kinoshita-lab/kinoshi-tiny-key-25/hardware/acrylic/kinoshi-tiny-key_acrylic-Edge_Cuts.dxf

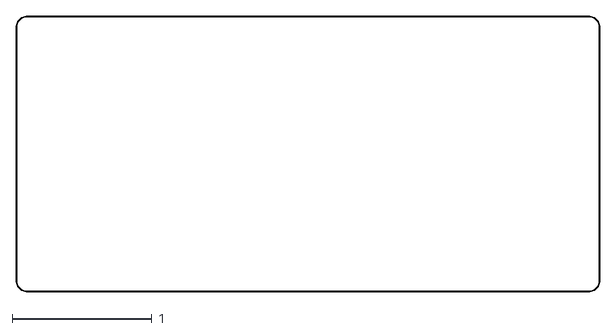
[picture p3: CAD file, 2025-10-02]
hardware/acrylic/kinoshi-tiny-key_acrylic-Edge_Cuts.dxf
4.18 x 1.97
