kinoshita-lab/kinoshi-tiny-key-25/hardware/kinoshi-tiny-key-25-pcb.pdf

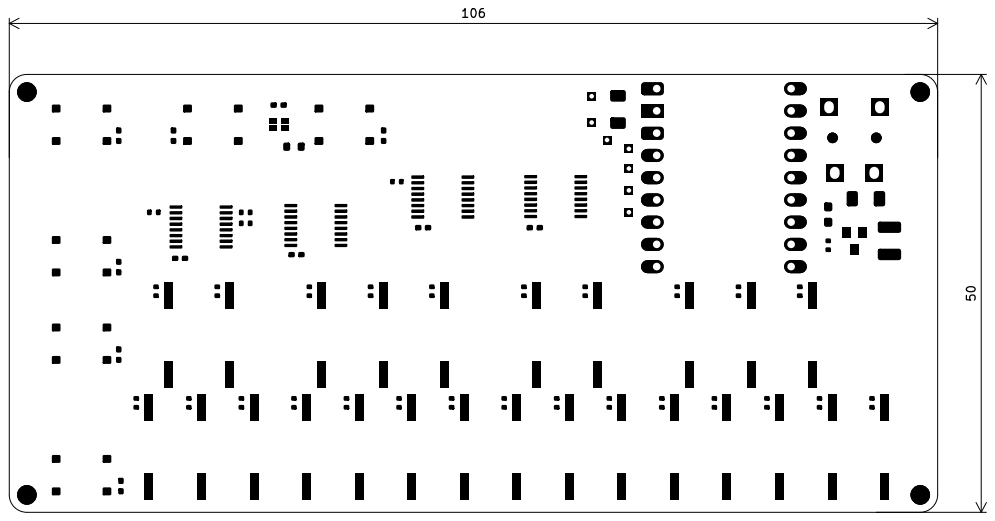
[picture p4: page 1]
