kinoshita-lab/kinoshi-tiny-key-25/hardware/kinoshi-tiny-key-25-schematics.pdf

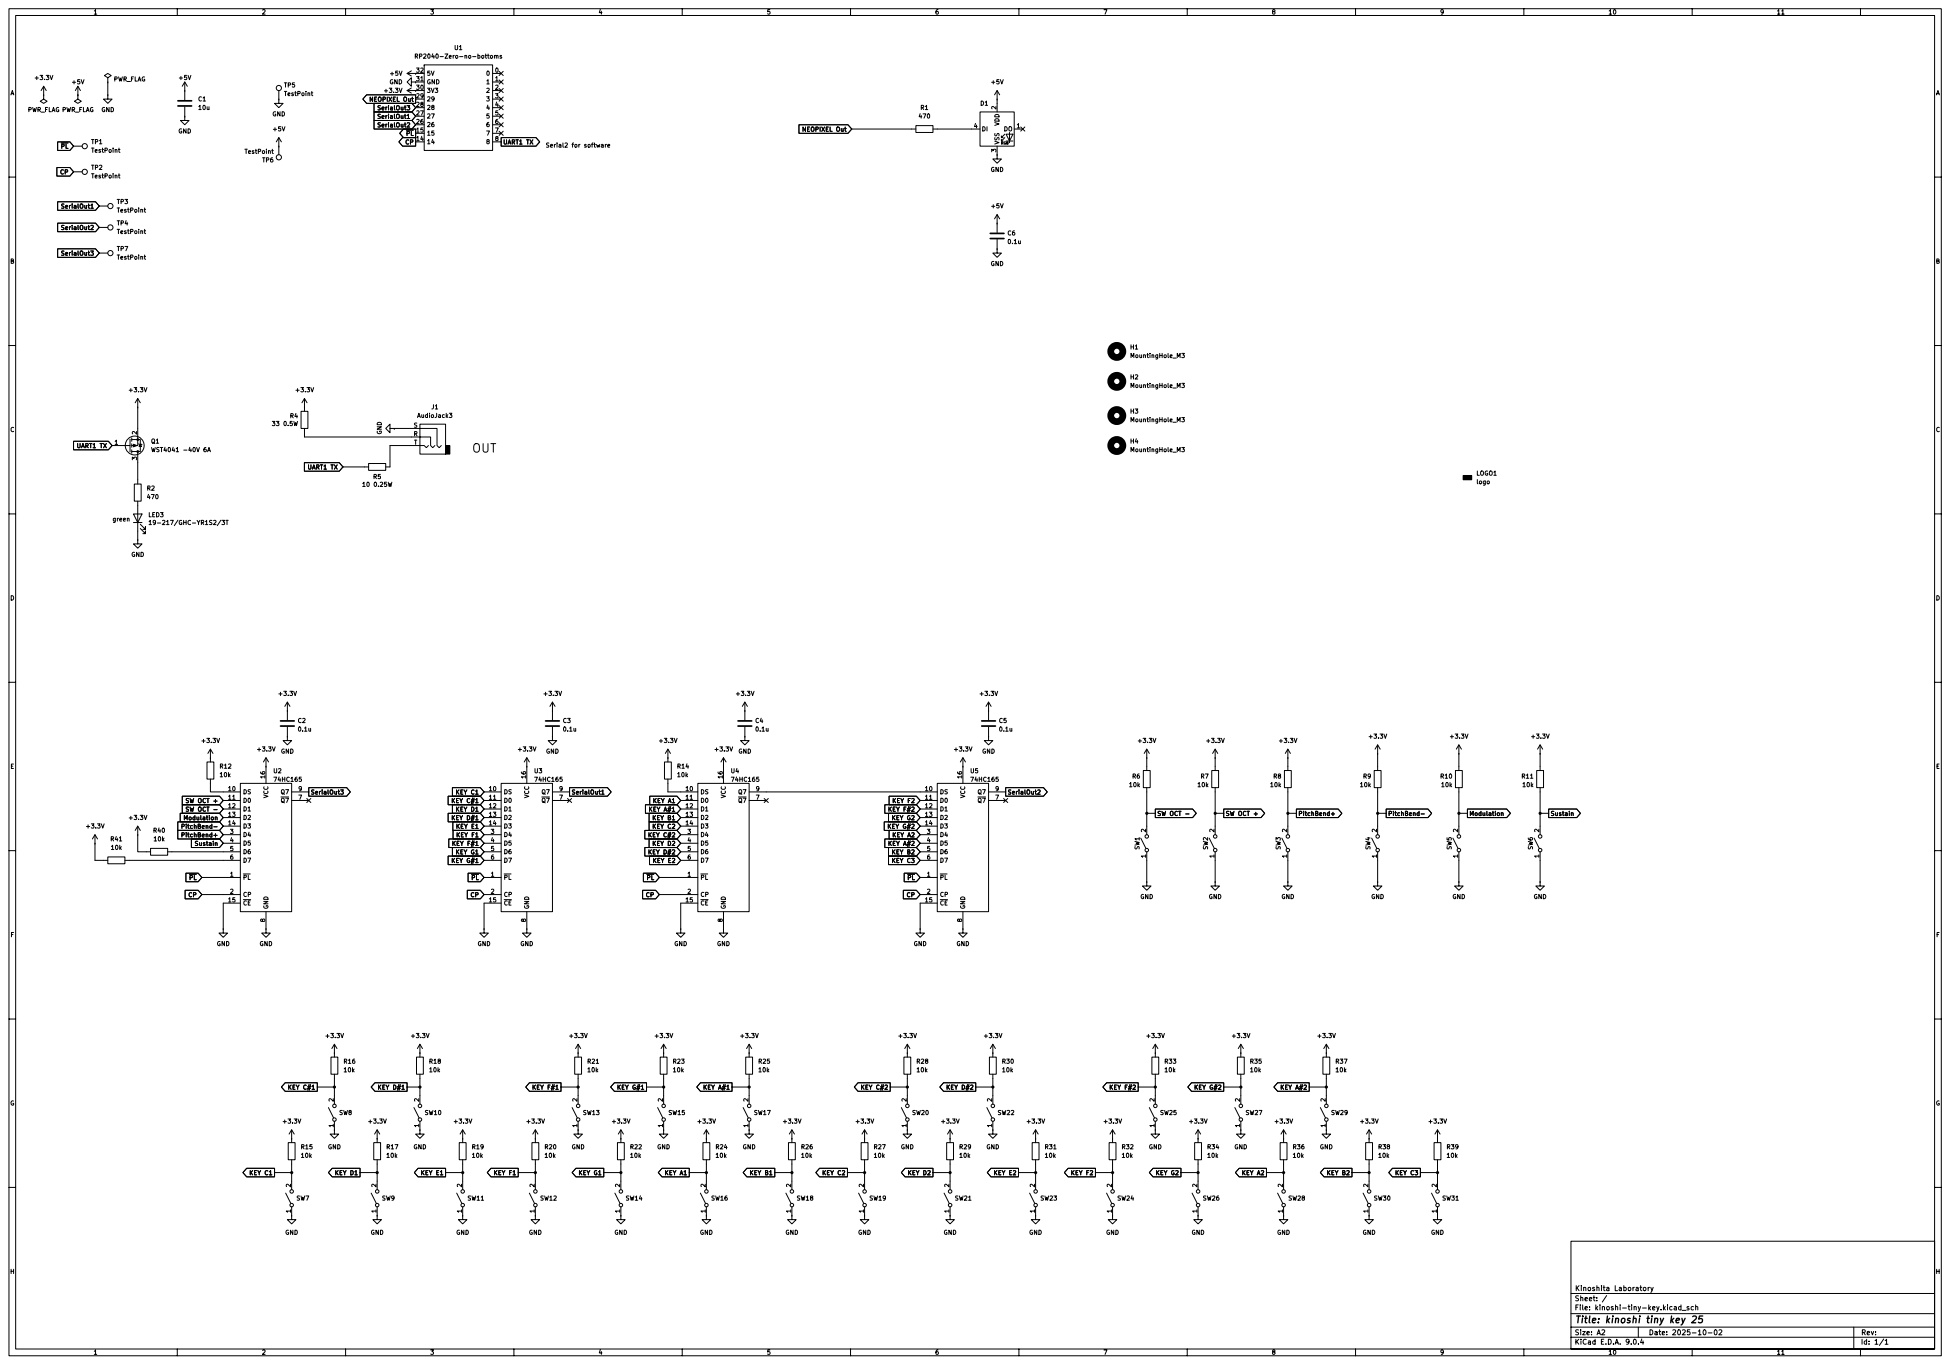
[picture p5: page 1]
