kinoshita-lab/kinoshi-tiny-key-25/hardware/kinoshi-tiny-key.kicad_pcb

## KiCad design hardware/kinoshi-tiny-key.kicad_pcb (2026-08-29)

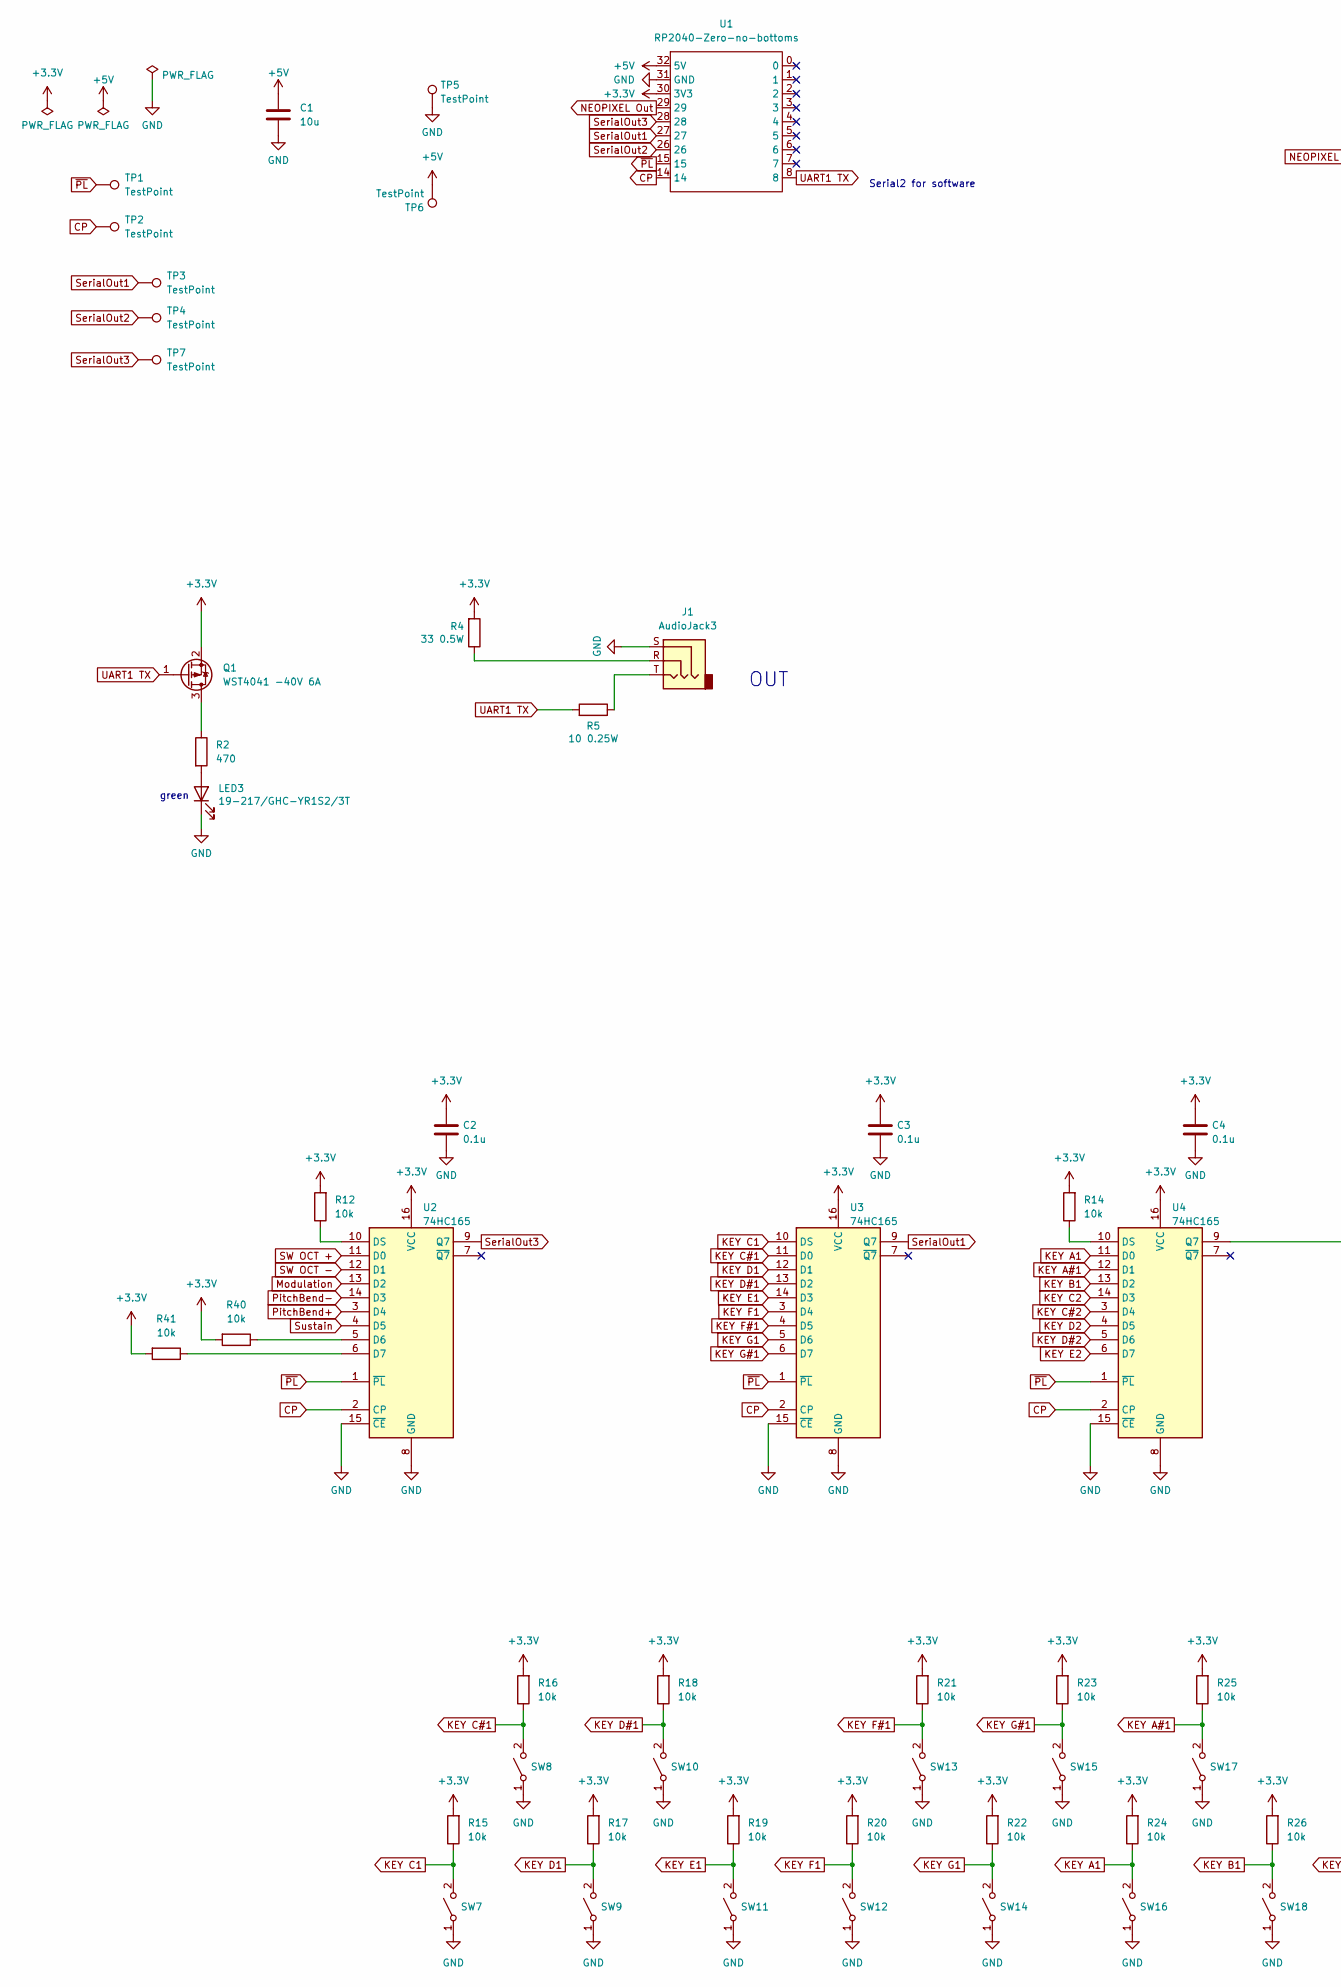
[picture p6: schematic kinoshi-tiny-key.kicad_sch, kinoshi tiny key 25, part in row 1, column 1]

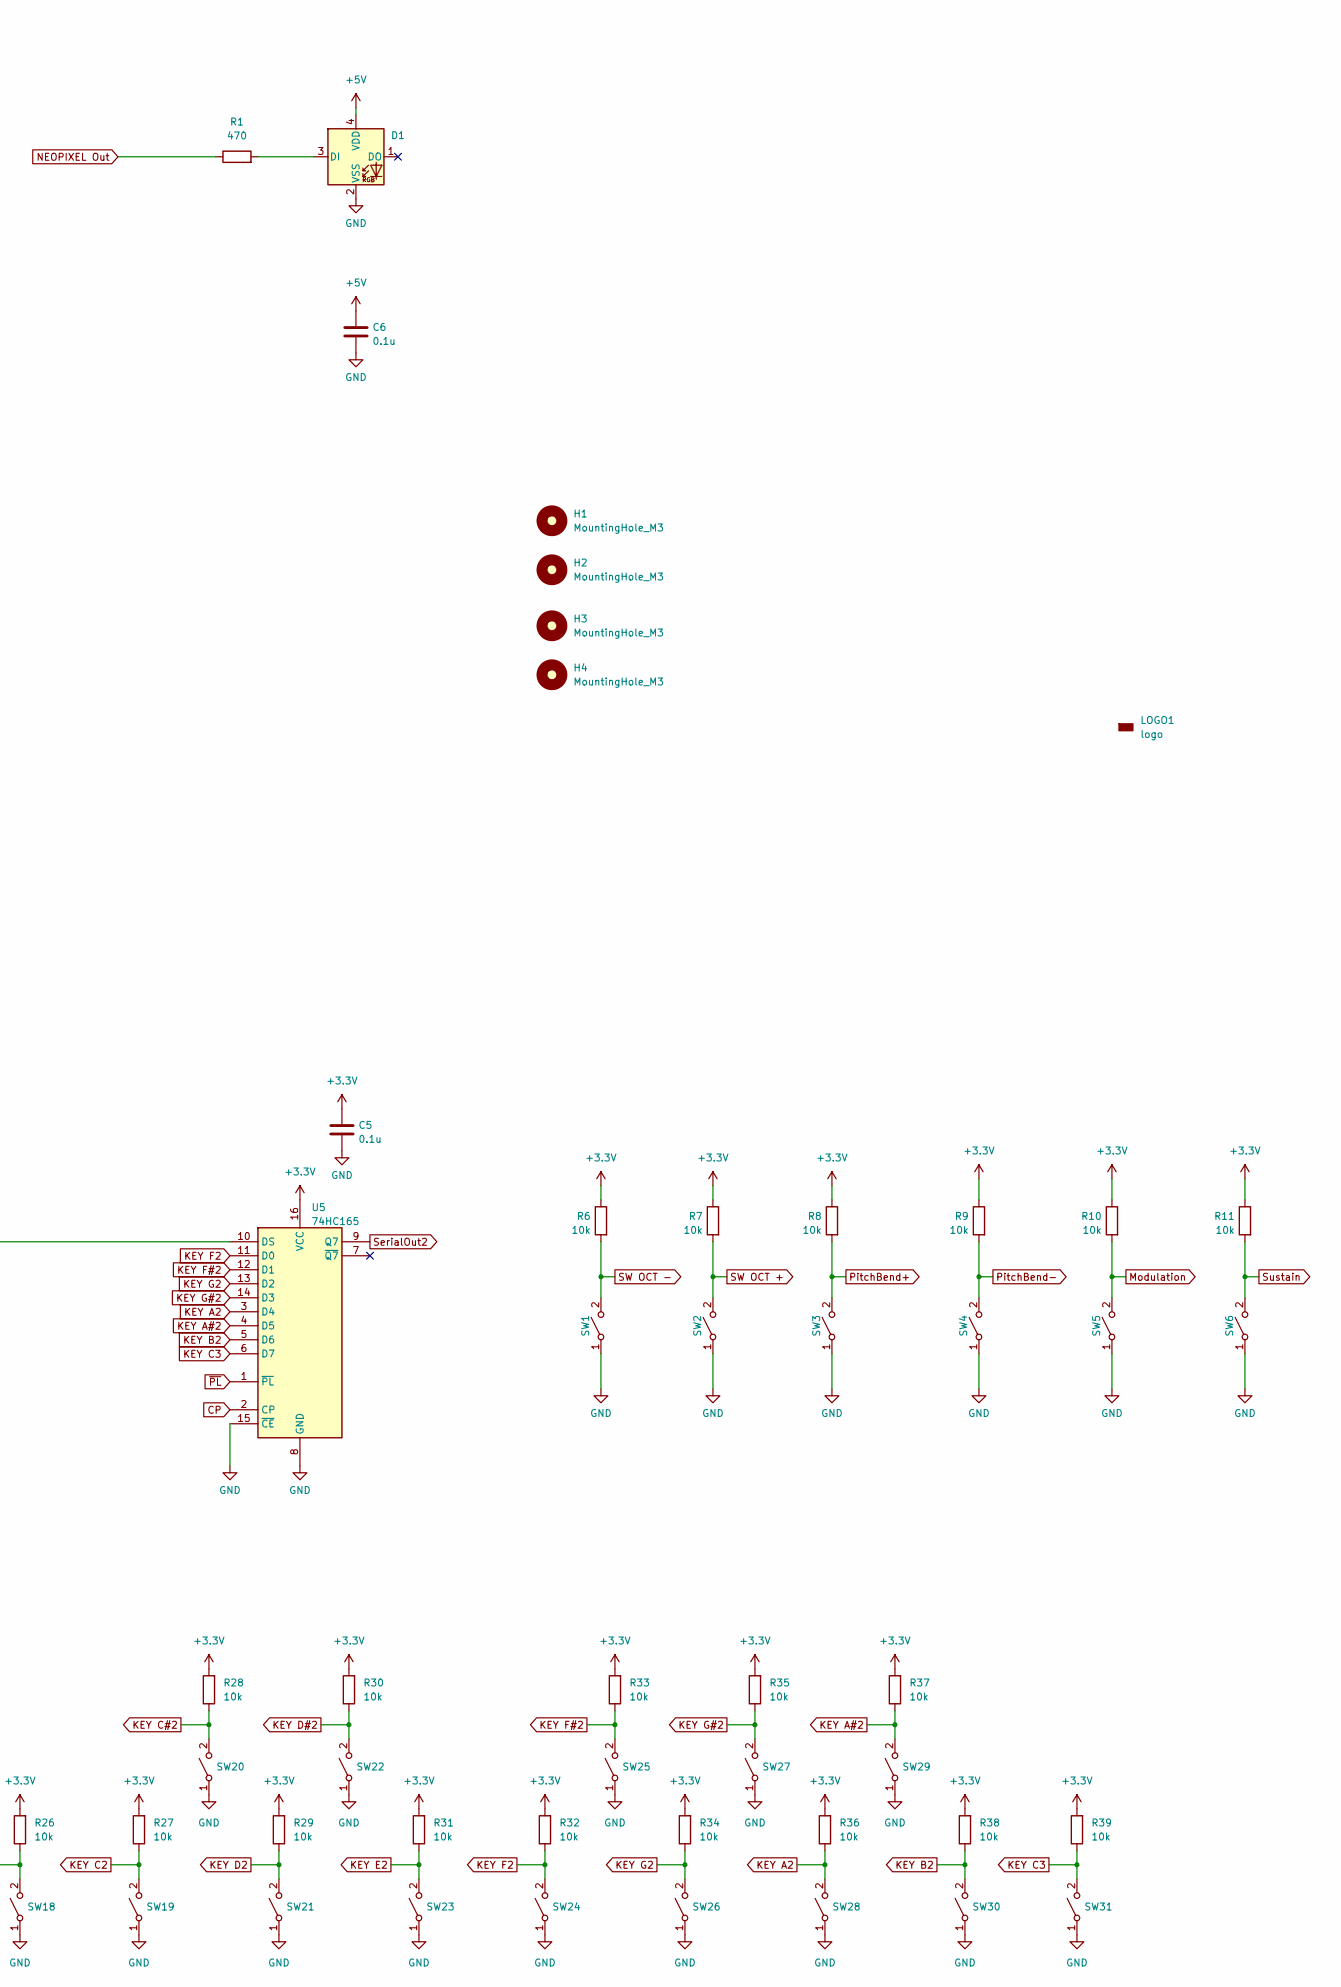
[picture p7: schematic kinoshi-tiny-key.kicad_sch, kinoshi tiny key 25, part in row 1, column 2]

Parts:
C1: 10u; C_1206_3216Metric_Pad1.33x1.80mm_HandSolder; LCSC C13585
C2, C3, C4, C5, C6: 0.1u; C_0402_1005Metric_Pad0.74x0.62mm_HandSolder; LCSC C1525
D1: LED_NeoPixel_CHONGTIAN_CT-1615UGRBC/H-P6-5_C52191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; LED_NeoPixel_CHONGTIAN CT-1615UGRBCH-P6-5_C52191312; LCSC C52191312
H1, H2, H3, H4: MountingHole_M3; MountingHole_2.2mm_M2
J1: AudioJack3; 3.5mm_Stereo_TRS_PJ-3210-4A_and_ST-005-G; LCSC C136686
LED3: 19-217/GHC-YR1S2/3T; LED_0603_1608Metric_Pad1.05x0.95mm_HandSolder; LCSC C72043
LOGO1: logo; kinoshita-logo_simplified_300dpi
Q1: WST4041 -40V 6A; SOT-23; LCSC C148357
R1: 470; R_0603_1608Metric; LCSC C23179
R2: 470; R_0402_1005Metric; LCSC C25117
R4: 33 0.5W; R_1210_3225Metric_Pad1.30x2.65mm_HandSolder; LCSC C407192
R5: 10 0.25W; R_1206_3216Metric_Pad1.30x1.75mm_HandSolder; LCSC C17903
R6, R7, R8, R9, R10, R11: 10k; R_0402_1005Metric_Pad0.72x0.64mm_HandSolder; LCSC C25744
R12, R14, R15, R16, R17, R18, R19, R20, R21, R22, R23, R24, R25, R26, R27, R28, R29, R30, R31, R32, R33, R34, R35, R36, R37, R38, R39, R40, R41: 10k; R_0402_1005Metric; LCSC C25744
SW1, SW2, SW3, SW4, SW5, SW6: SW_SPST; Switch_Tactile_TS1187A26017_C22459525; LCSC C22459525
SW7, SW8, SW9, SW10, SW11, SW12, SW13, SW14, SW15, SW16, SW17, SW18, SW19, SW20, SW21, SW22, SW23, SW24, SW25, SW26, SW27, SW28, SW29, SW30, SW31: SW_SPST; Switch_Tactile_TSB008A2518A_C2888455; LCSC C2888456
TP1, TP2, TP3, TP4, TP5, TP6, TP7: TestPoint; TestPoint_THTPad_1.0x1.0mm_Drill0.5mm
U1: RP2040-Zero-no-bottoms; RP2040-Zero-THT-no-bottoms
U2, U3, U4, U5: 74HC165; TSSOP-16_4.4x5mm_P0.65mm; LCSC C80696

Connections:
+3.3V: C2.1, C3.1, C4.1, C5.1, Q1.2 (S), R4.2, R6.1, R7.1, R8.1, R9.1, R10.1, R11.1, R12.2, R14.2, R15.2, R16.2, R17.2, R18.2, R19.2, R20.2, R21.2, R22.2, R23.2, R24.2, R25.2, R26.2, R27.2, R28.2, R29.2, R30.2, R31.2, R32.2, R33.2, R34.2, R35.2, R36.2, R37.2, R38.2, R39.2, R40.2, R41.2, U1.30 (3V3), U2.16 (VCC), U3.16 (VCC), U4.16 (VCC), U5.16 (VCC)
+5V: C1.1, C6.1, D1.4 (VDD), TP6.1 (1_1), U1.32 (5V)
CP: TP2.1 (1_1), U1.14, U2.2 (CP), U3.2 (CP), U4.2 (CP), U5.2 (CP)
GND: C1.2, C2.2, C3.2, C4.2, C5.2, C6.2, D1.2 (VSS), J1.S, LED3.1 (K), SW1.1 (A), SW2.1 (A), SW3.1 (A), SW4.1 (A), SW5.1 (A), SW6.1 (A), SW7.1 (A), SW8.1 (A), SW9.1 (A), SW10.1 (A), SW11.1 (A), SW12.1 (A), SW13.1 (A), SW14.1 (A), SW15.1 (A), SW16.1 (A), SW17.1 (A), SW18.1 (A), SW19.1 (A), SW20.1 (A), SW21.1 (A), SW22.1 (A), SW23.1 (A), SW24.1 (A), SW25.1 (A), SW26.1 (A), SW27.1 (A), SW28.1 (A), SW29.1 (A), SW30.1 (A), SW31.1 (A), TP5.1 (1_1), U1.31 (GND), U2.8 (GND), U2.15 (~CE), U3.8 (GND), U3.15 (~CE), U4.8 (GND), U4.15 (~CE), U5.8 (GND), U5.15 (~CE)
KEY A1: R24.1, SW16.2 (B), U4.11 (D0)
KEY A2: R36.1, SW28.2 (B), U5.3 (D4)
KEY A#1: R25.1, SW17.2 (B), U4.12 (D1)
KEY A#2: R37.1, SW29.2 (B), U5.4 (D5)
KEY B1: R26.1, SW18.2 (B), U4.13 (D2)
KEY B2: R38.1, SW30.2 (B), U5.5 (D6)
KEY C1: R15.1, SW7.2 (B), U3.10 (DS)
KEY C2: R27.1, SW19.2 (B), U4.14 (D3)
KEY C3: R39.1, SW31.2 (B), U5.6 (D7)
KEY C#1: R16.1, SW8.2 (B), U3.11 (D0)
KEY C#2: R28.1, SW20.2 (B), U4.3 (D4)
KEY D1: R17.1, SW9.2 (B), U3.12 (D1)
KEY D2: R29.1, SW21.2 (B), U4.4 (D5)
KEY D#1: R18.1, SW10.2 (B), U3.13 (D2)
KEY D#2: R30.1, SW22.2 (B), U4.5 (D6)
KEY E1: R19.1, SW11.2 (B), U3.14 (D3)
KEY E2: R31.1, SW23.2 (B), U4.6 (D7)
KEY F1: R20.1, SW12.2 (B), U3.3 (D4)
KEY F2: R32.1, SW24.2 (B), U5.11 (D0)
KEY F#1: R21.1, SW13.2 (B), U3.4 (D5)
KEY F#2: R33.1, SW25.2 (B), U5.12 (D1)
KEY G1: R22.1, SW14.2 (B), U3.5 (D6)
KEY G2: R34.1, SW26.2 (B), U5.13 (D2)
KEY G#1: R23.1, SW15.2 (B), U3.6 (D7)
KEY G#2: R35.1, SW27.2 (B), U5.14 (D3)
Modulation: R10.2, SW5.2 (B), U2.13 (D2)
NEOPIXEL Out: R1.1, U1.29
unnamed: D1.3 (DI), R1.2
unnamed: J1.R, R4.1
unnamed: J1.T, R5.1
unnamed: LED3.2 (A), R2.2
unnamed: Q1.3 (D), R2.1
unnamed: R40.1, U2.5 (D6)
unnamed: R41.1, U2.6 (D7)
unnamed: R12.1, U2.10 (DS)
unnamed: R14.1, U4.10 (DS)
unnamed: U4.9 (Q7), U5.10 (DS)
PitchBend+: R8.2, SW3.2 (B), U2.3 (D4)
PitchBend-: R9.2, SW4.2 (B), U2.14 (D3)
SW OCT +: R7.2, SW2.2 (B), U2.11 (D0)
SW OCT -: R6.2, SW1.2 (B), U2.12 (D1)
SerialOut1: TP3.1 (1_1), U1.27, U3.9 (Q7)
SerialOut2: TP4.1 (1_1), U1.26, U5.9 (Q7)
SerialOut3: TP7.1 (1_1), U1.28, U2.9 (Q7)
Sustain: R11.2, SW6.2 (B), U2.4 (D5)
UART1 TX: Q1.1 (G), R5.2, U1.8
~PL: TP1.1 (1_1), U1.15, U2.1 (~PL), U3.1 (~PL), U4.1 (~PL), U5.1 (~PL)

Notes on the sheet:
OUT
Serial2 for software
green

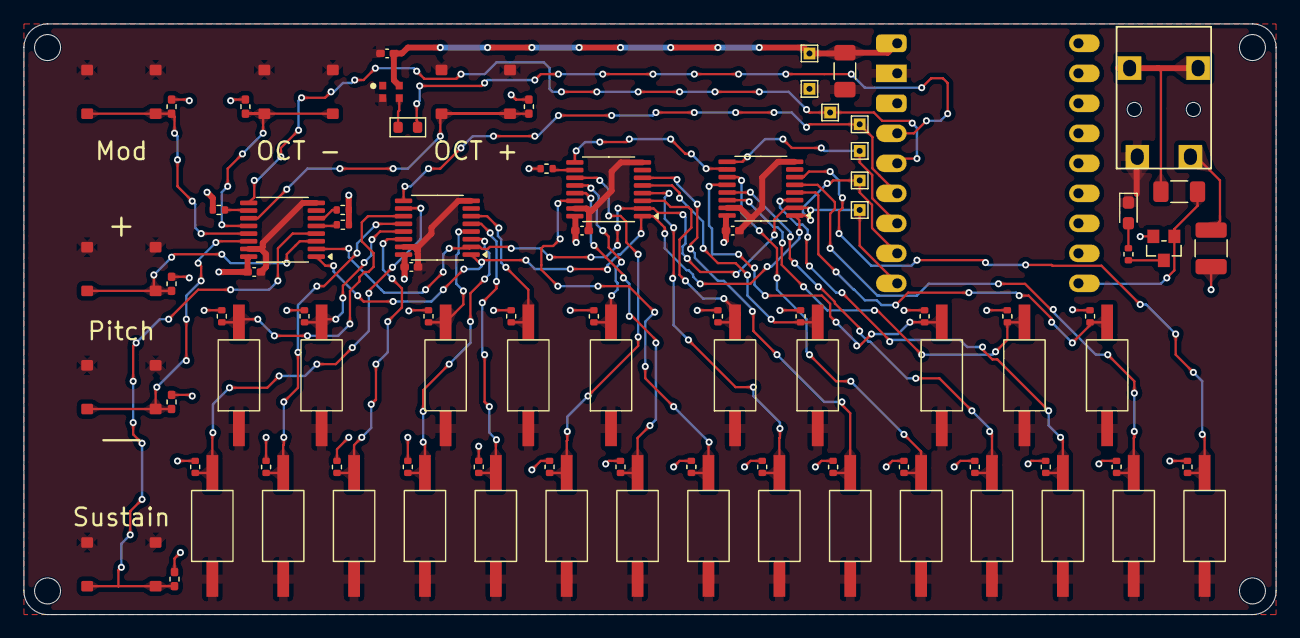
[picture p8: board kinoshi-tiny-key.kicad_pcb from above]

Board: 2 copper layers, 106.0 x 50.0 mm, 97 parts (1 on the bottom side), 51 nets.
