kinoshita-lab/kinoshi-tiny-key-25/software/kinoshi-tiny-key-25/src/application.cpp

/**
 * @file	application.cpp
 * @brief	Application logic for Tiny KinoKey 25
 * @author Kazuki Saita <saita@kinoshita-lab.com>
 * Copyright (c) 2025 Kinoshita Laboratory All rights reserved.
 */
#include <Arduino.h>
#include <algorithm>
#include "application.h"
#include "leds.h"
#include "device_config.h"
#include "switch.hpp"
#include "midi_process.h"
#include "pins.h"
#include "user_config.h"
#include "setting_transfer.h"

extern "C" {
#include "pico/bootrom.h"
}

namespace kinoshita_lab::kinoshi_tiny_key_25::application
{
namespace
{
enum ButtonIndex
{
    kButtonMod,
    kButtonPitchUp,
    kButtonPitchDown,
    kButtonSustain,
    kNumButtons,
};

switches::Switches switches_(pins::kPinPl, pins::kPinCp, pins::kPinSerialOut1, pins::kPinSerialOut2, pins::kPinSerialOut3, nullptr);

struct Status
{
    bool timer_fired            = false;
    int current_octave          = device_config::kDefaultOctave;
    int16_t pitch_bend_value    = 0;  // center
    int pitch_bend_direction    = 0;  // -1, 0, 1
    bool should_send_pitch_bend = false;
    const float pitch_bend_step = (8192.f / (device_config::pitch_bend_time / 1000.f)) / (1000.f * 1000.f / device_config::kApplicationTimerIntervalUs);  // per timer tick
    struct KeyboardStatus
    {
        bool shouldSend;
        bool offOn;
        int8_t noteOnNoteNumber = -1;  // MIDI note number for "Note On" event
    };
    KeyboardStatus keyboard_status[device_config::kNumKeyboardKeys];
    bool button_toggle_on[kNumButtons] = {};  // current state of toggle mode buttons
};
Status status_;

void setOctaveWithDelta(const int delta)
{
    const auto prev    = status_.current_octave;
    const auto new_val = std::clamp<int>(prev + delta, device_config::kMinOctave, device_config::kMaxOctave);
    if (new_val == prev) {
        return;
    }
    Serial.printf("Octave changed: %d -> %d\n", prev, new_val);
    leds::setOctaveLed(new_val);
    status_.current_octave = new_val;
}

void handleCcButton(const ButtonIndex index, const user_config::ButtonConfig& button, const bool pressed)
{
    if (button.mode == user_config::kButtonModeToggle) {
        if (!pressed) {
            return;  // toggle mode sends nothing on release
        }
        status_.button_toggle_on[index] = !status_.button_toggle_on[index];
        midi_process::sendControlChange(button.cc_number, status_.button_toggle_on[index] ? button.on_value : button.off_value);
        return;
    }
    midi_process::sendControlChange(button.cc_number, pressed ? button.on_value : button.off_value);
}

void handlePitchButton(const ButtonIndex index, const user_config::ButtonConfig& button, const int direction, const bool pressed)
{
    if (button.function == user_config::kButtonFunctionCc) {
        handleCcButton(index, button, pressed);
        return;
    }
    status_.pitch_bend_direction   = pressed ? direction : 0;
    status_.should_send_pitch_bend = true;  // send immediately
}

// Called when the editor changed a setting.
void settingsChanged()
{
    // a button may have changed its function or mode while held: start over from released state
    for (auto& toggle_on : status_.button_toggle_on) {
        toggle_on = false;
    }
    if (status_.pitch_bend_direction != 0 || status_.pitch_bend_value != 0) {
        status_.pitch_bend_direction   = 0;
        status_.should_send_pitch_bend = true;  // return to center
    }
}

// Called when the editor starts transmitting settings.
void transferStarted()
{
    // the receiver is silenced and reset below, so forget everything held
    for (auto& key : status_.keyboard_status) {
        key.noteOnNoteNumber = -1;
    }
    for (auto& toggle_on : status_.button_toggle_on) {
        toggle_on = false;
    }
    status_.pitch_bend_direction   = 0;
    status_.pitch_bend_value       = 0;
    status_.should_send_pitch_bend = false;

    midi_process::sendAllNotesOff();
    midi_process::sendResetAllControllers();
    Serial.printf("All Notes Off / Reset All Controllers sent\n");
}
}
void initialize()
{
    leds::initialize();
    status_.current_octave = device_config::kDefaultOctave;
    // initial switch read
    switches_.forceScan();

    // read switch status for boot combos
    const auto modulation_on = switches_.switchIsOn(switches::Switches::kSwitchIdModulation);
    const auto oct_minus_on  = switches_.switchIsOn(switches::Switches::kSwitchIdOctMinus);
    const auto oct_plus_on   = switches_.switchIsOn(switches::Switches::kSwitchIdOctPlus);

    if (modulation_on && oct_minus_on && oct_plus_on) {
        // all three pressed: invalid combination, boot normally
        Serial.printf("Invalid boot combo ignored\n");
    } else if (modulation_on && oct_minus_on) {
        // update mode: blink blue, then enter UF2 boot mode
        leds::blink(device_config::kUpdateModeBlinkColor, device_config::kStatusBlinkCount,
                    device_config::kStatusBlinkIntervalMs);
        reset_usb_boot(0, 0);
        return;
    } else if (oct_minus_on && oct_plus_on) {
        // factory reset: blink red, then clear user config
        leds::blink(device_config::kFactoryResetBlinkColor, device_config::kStatusBlinkCount,
                    device_config::kStatusBlinkIntervalMs);
        user_config::reset();
        Serial.printf("Factory reset: user config cleared\n");
    } else {
        const auto config_loaded = user_config::load();
        Serial.printf("User config %s: usb_midi_channel=%d, trs_midi_channel=%d\n",
                      config_loaded ? "loaded from flash" : "reset to defaults",
                      user_config::config.usb_midi_channel, user_config::config.trs_midi_channel);
        if (!config_loaded) {
            user_config::save();
        }
    }

    switches_.setHandler(switchStateChanged);
    leds::setOctaveLed(status_.current_octave);
    midi_process::initialize();
    setting_transfer::initialize(settingsChanged, transferStarted);
}

void timerFired()
{
    status_.timer_fired = true;  // rough timer flag
    // process pitch bend(cannot process in idle loop because of timing)
    // calc value, send on loop
    if (status_.pitch_bend_direction != 0) {
        const auto new_pitch_bend_value = std::clamp<int16_t>(status_.pitch_bend_value + status_.pitch_bend_direction * status_.pitch_bend_step, -8192, 8191);
        if (new_pitch_bend_value == status_.pitch_bend_value) {
            // reached max/min
            return;
        }
        status_.pitch_bend_value       = new_pitch_bend_value;
        status_.should_send_pitch_bend = true;
    }
}

void processKeyboard()
{
    for (auto i = 0; i < device_config::kNumKeyboardKeys; ++i) {
        if (status_.keyboard_status[i].shouldSend) {
            status_.keyboard_status[i].shouldSend = false;
            if (status_.keyboard_status[i].offOn) {
                // on
                constexpr int num_note_per_octave           = 12;
                const auto on_note_number                   = (status_.current_octave + 1) * num_note_per_octave + i;
                status_.keyboard_status[i].noteOnNoteNumber = on_note_number;
                const auto velocity                         = user_config::config.velocity;
                midi_process::sendNoteOn(on_note_number, velocity);
                Serial.printf("Note On sent: note=%d, velocity=%d\n", on_note_number, velocity);
            } else {  // off
                const auto off_note_number = status_.keyboard_status[i].noteOnNoteNumber;
                if (off_note_number >= 0) {
                    midi_process::sendNoteOff(off_note_number, 0);
                    Serial.printf("Note Off sent: note=%d, velocity=0\n", off_note_number);
                    status_.keyboard_status[i].noteOnNoteNumber = -1;
                }
            }
        }
    }
}

void switchStateChanged(uint32_t switch_index, const int off_on)
{
    Serial.printf("Switch %d is %s\n", switch_index, off_on ? "ON" : "OFF");

    switch (switch_index) {
        case switches::Switches::kSwitchIdC1... switches::Switches::kSwitchIdF2: {  // keyboard keys
            const auto key_index                          = switch_index - switches::Switches::kSwitchIdC1;
            status_.keyboard_status[key_index].shouldSend = true;
            status_.keyboard_status[key_index].offOn      = off_on;
        }
            return;
        case switches::Switches::kSwitchIdSustain:
            handleCcButton(kButtonSustain, user_config::config.sustain, off_on != 0);
            return;
        case switches::Switches::kSwitchIdModulation:
            handleCcButton(kButtonMod, user_config::config.mod, off_on != 0);
            return;
        case switches::Switches::kSwitchIdPitchBendPlus:
            handlePitchButton(kButtonPitchUp, user_config::config.pitch_up, 1, off_on != 0);
            return;
        case switches::Switches::kSwitchIdPitchBendMinus:
            handlePitchButton(kButtonPitchDown, user_config::config.pitch_down, -1, off_on != 0);
            return;
        default:
            break;
    }

    // on trigger switches
    if (off_on) {
        switch (switch_index) {
            case switches::Switches::kSwitchIdOctMinus:
                setOctaveWithDelta(-1);
                break;
            case switches::Switches::kSwitchIdOctPlus:
                setOctaveWithDelta(1);
                break;
            default:
                break;
        }
        return;
    }
}
void processPitchBend();

void loop()
{
    switches_.update();
    processTimerTick();
    processKeyboard();
    processPitchBend();
    midi_process::loop();
}
void processPitchBend()
{
    if (!status_.should_send_pitch_bend) {
        return;
    }
    status_.should_send_pitch_bend = false;

    if (status_.pitch_bend_direction == 0) {
        status_.pitch_bend_value = 0;  // reset to center when stopped
    }

    midi_process::sendPitchBend(status_.pitch_bend_value);
}

void processTimerTick()
{
    if (!status_.timer_fired) {
        return;
    }
    status_.timer_fired = false;
}
}  // namespace kinoshita_lab::kinoshi_tiny_key_25::application
