kinoshita-lab/kinoshi-tiny-key-25/software/kinoshi-tiny-key-25/src/leds.cpp

/**
 * @file	leds.cpp
 * @brief	LED control for Tiny KinoKey 25
 * @author Kazuki Saita <saita@kinoshita-lab.com>
 * Copyright (c) 2025 Kinoshita Laboratory All rights reserved.
 */
#include "FastLED.h"
#include "leds.h"
#include "pins.h"
#include "device_config.h"
namespace
{
CRGB oct_led[1];
}

namespace kinoshita_lab::kinoshi_tiny_key_25::leds
{
void initialize()
{
    FastLED.addLeds<NEOPIXEL, pins::kPinOctaveNeoPixel>(oct_led, 1);
    FastLED.setBrightness(20);
    FastLED.show();
}

void setOctaveLed(const int octave)
{ 
    if (octave < device_config::kMinOctave || octave > device_config::kMaxOctave) {
        return;
    }
    const auto index = octave - device_config::kMinOctave;
    const auto& c   = device_config::kOctaveColors[index];
    oct_led[0].setRGB(c.r, c.g, c.b);
    FastLED.show();
}

void blink(const Color& color, const int count, const uint32_t interval_ms)
{
    for (auto i = 0; i < count; ++i) {
        oct_led[0].setRGB(color.r, color.g, color.b);
        FastLED.show();
        delay(interval_ms);
        oct_led[0].setRGB(0, 0, 0);
        FastLED.show();
        delay(interval_ms);
    }
}
}
