kinoshita-lab/kinoshi-tiny-key-25/software/kinoshi-tiny-key-25/src/leds.h

/**
 * @file	leds.h
 * @brief	LED control for Tiny KinoKey 25
 * @author Kazuki Saita <saita@kinoshita-lab.com>
 * Copyright (c) 2025 Kinoshita Laboratory All rights reserved.
 */
#pragma once
#ifndef LEDS_H
#define LEDS_H

#include <cstdint>

namespace kinoshita_lab::kinoshi_tiny_key_25::leds
{
struct Color
{
    uint8_t r;
    uint8_t g;
    uint8_t b;
};

enum
{
    kLedBuiltin,
    kLedOctave,
};
void initialize();

void setOctaveLed(const int octave);

/// Blinks the octave LED with the given color. Blocking call (uses delay()).
void blink(const Color& color, int count, uint32_t interval_ms);
} // namespace kinoshita_lab::tiny_kino_key_25::leds

#endif // LEDS_H
