kinoshita-lab/kinoshi-tiny-key-25/(commit log)

2025-10-02 hardware: add files
    [kinoshi-tiny-key.kicad_pcb, kinoshi-tiny-key.kicad_sch, kinoshi-tiny-key_acrylic-Edge_Cuts.dxf, kinoshi-tiny-key_acrylic.kicad_pcb]
2025-10-02 hard: add pdfs
    [kinoshi-tiny-key.kicad_pcb, kinoshi-tiny-key.kicad_sch]
2026-08-17 [firmware] rename DeviceConfig header and namespace
2026-08-17 [firmware] normalize device_config filename
2026-08-17 [hard] Update KiCad version
    [kinoshi-tiny-key.kicad_pcb]
2026-08-29 [hardware] update kicad version
    [kinoshi-tiny-key.kicad_pcb, kinoshi-tiny-key.kicad_sch]
